sumitedu1305-embedd/ultrasonic_anemometer/PCB/new_pcb_v2/new_pcb_v2.step

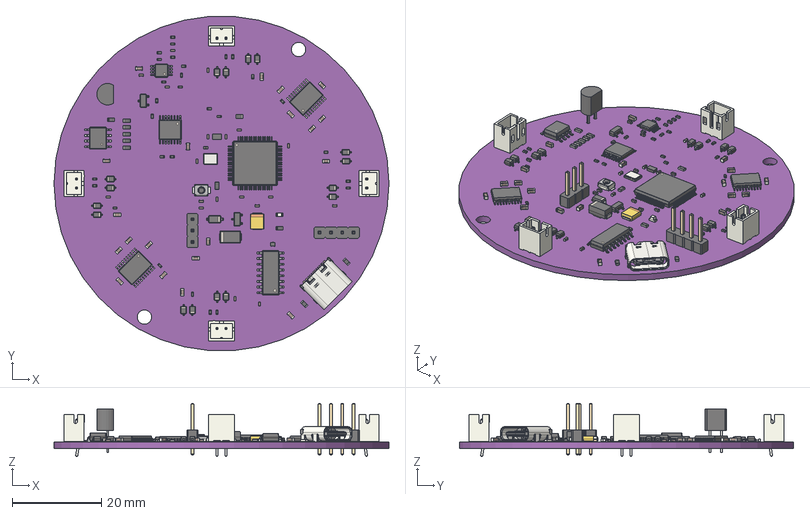
[picture p1: CAD file, 2026-08-26]
PCB/new_pcb_v2/new_pcb_v2.step
75.0 x 74.8 x 11.9 mm
SOT-23-3 x 2
PinHeader_1x03_P254mm_Vertical
C_0603_1608Metric x 20
R_0402_1005Metric x 29
D_SOD-323 x 16
MSOP-8_3x3mm_P0.65mm
C_0402_1005Metric x 20
SW_SPST_B3U-1000P
SO-8_3.9x4.9mm_P1.27mm
DRT_3
R_0603_1608Metric x 11
Crystal_SMD_Abracon_ABM8G-4Pin_3.2x2.5mm
JST_B2B_PH_K x 4
USB_C_Receptacle_16P_TopMnt_Horizontal_GCT_USB4105-xx-A
D_SOD-123
CP_EIA_3528_12_Kemet_T
TSSOP-16_4.4x5mm_P0.65mm
D_SMA
MicroCrystal_CC8V_T1A
PinHeader_1x04_P254mm_Vertical
SOIC-16_3.9x9.9mm_P1.27mm
LQFP-64_10x10mm_P0.5mm
TSSOP-20_4.4x6.5mm_P0.65mm x 2
LED_0603_1608Metric
TO-92-2_Narrow
new_pcb_v2_PCB
