sumitedu1305-embedd/ultrasonic_anemometer/PCB/new_pcb_v2/new_pcb_v2.pdf

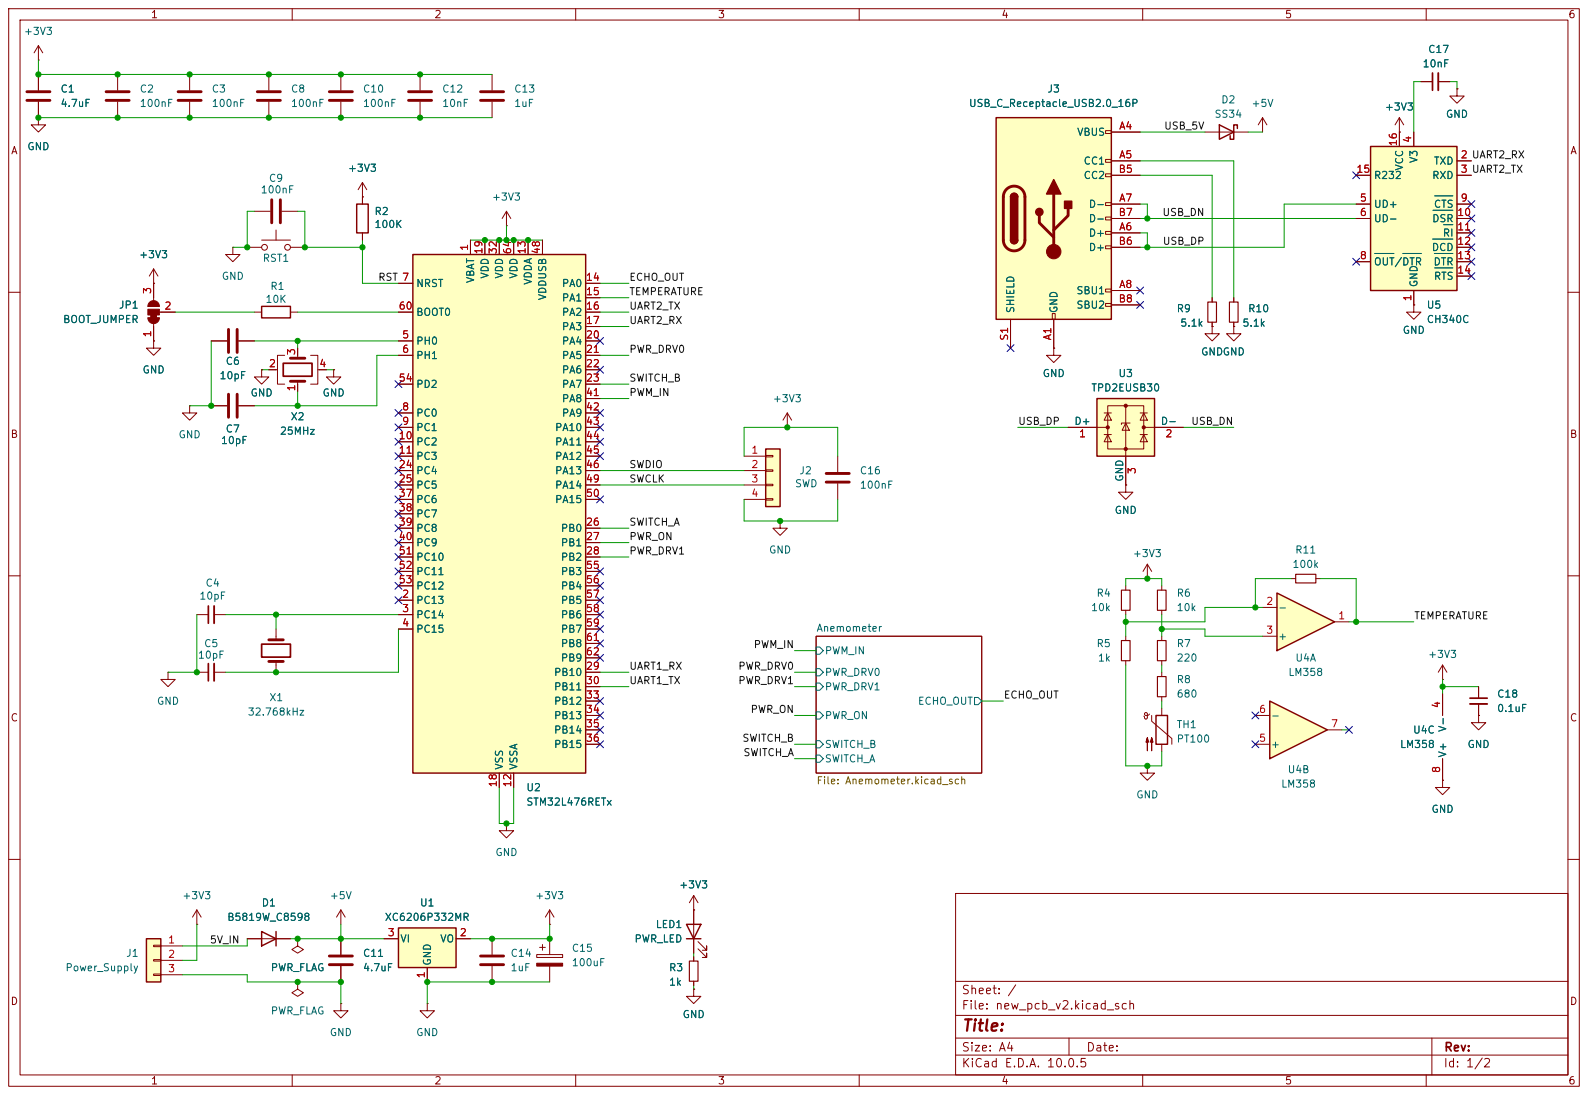
[picture p2: page 1]

4 UD+ 5 UD- 6 OUT/DTR 8 CTS 9 DSR 10 RI 11 DCD 12 DTR 13 RTS 14 R232 15 VCC 16 U5CH340C +5V D+

4 UD+ 5 UD- 6 OUT/DTR 8 CTS 9 DSR 10 RI 11 DCD 12 DTR 13 RTS 14 R232 15 VCC 16 GND

Size: A4 | Rev:
KiCad E.D.A. 10.0.5 | Id: 1/2

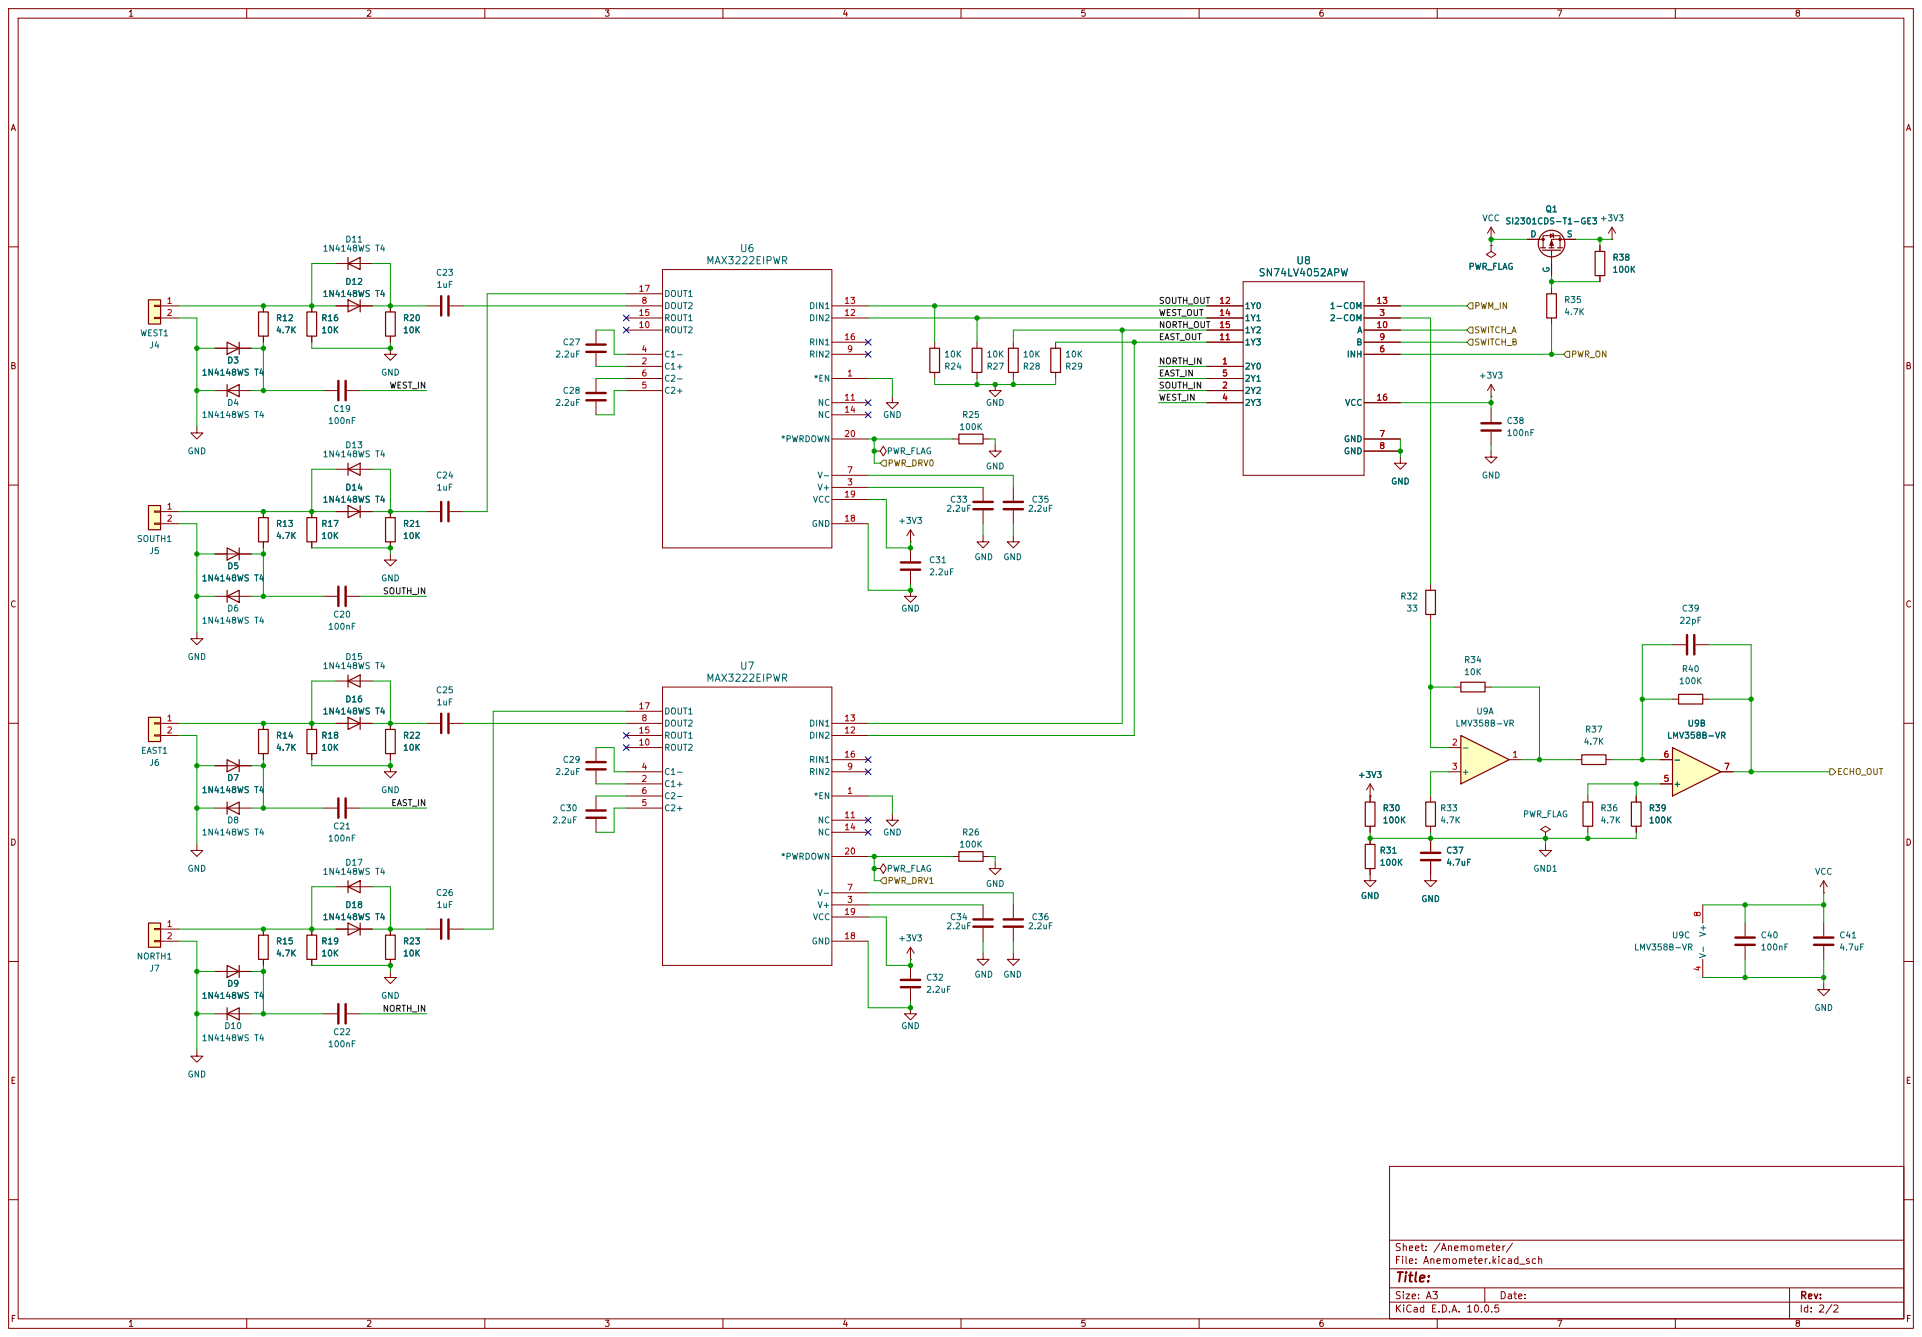
[picture p3: page 2]

Size: A3 | Rev: | F Date:
KiCad E.D.A. 10.0.5 | Id: 2/2
