sumitedu1305-embedd/ultrasonic_anemometer/PCB/new_pcb_v2/new_pcb_v2.kicad_pcb

## KiCad design PCB/new_pcb_v2/new_pcb_v2.kicad_pcb (2026-08-26)

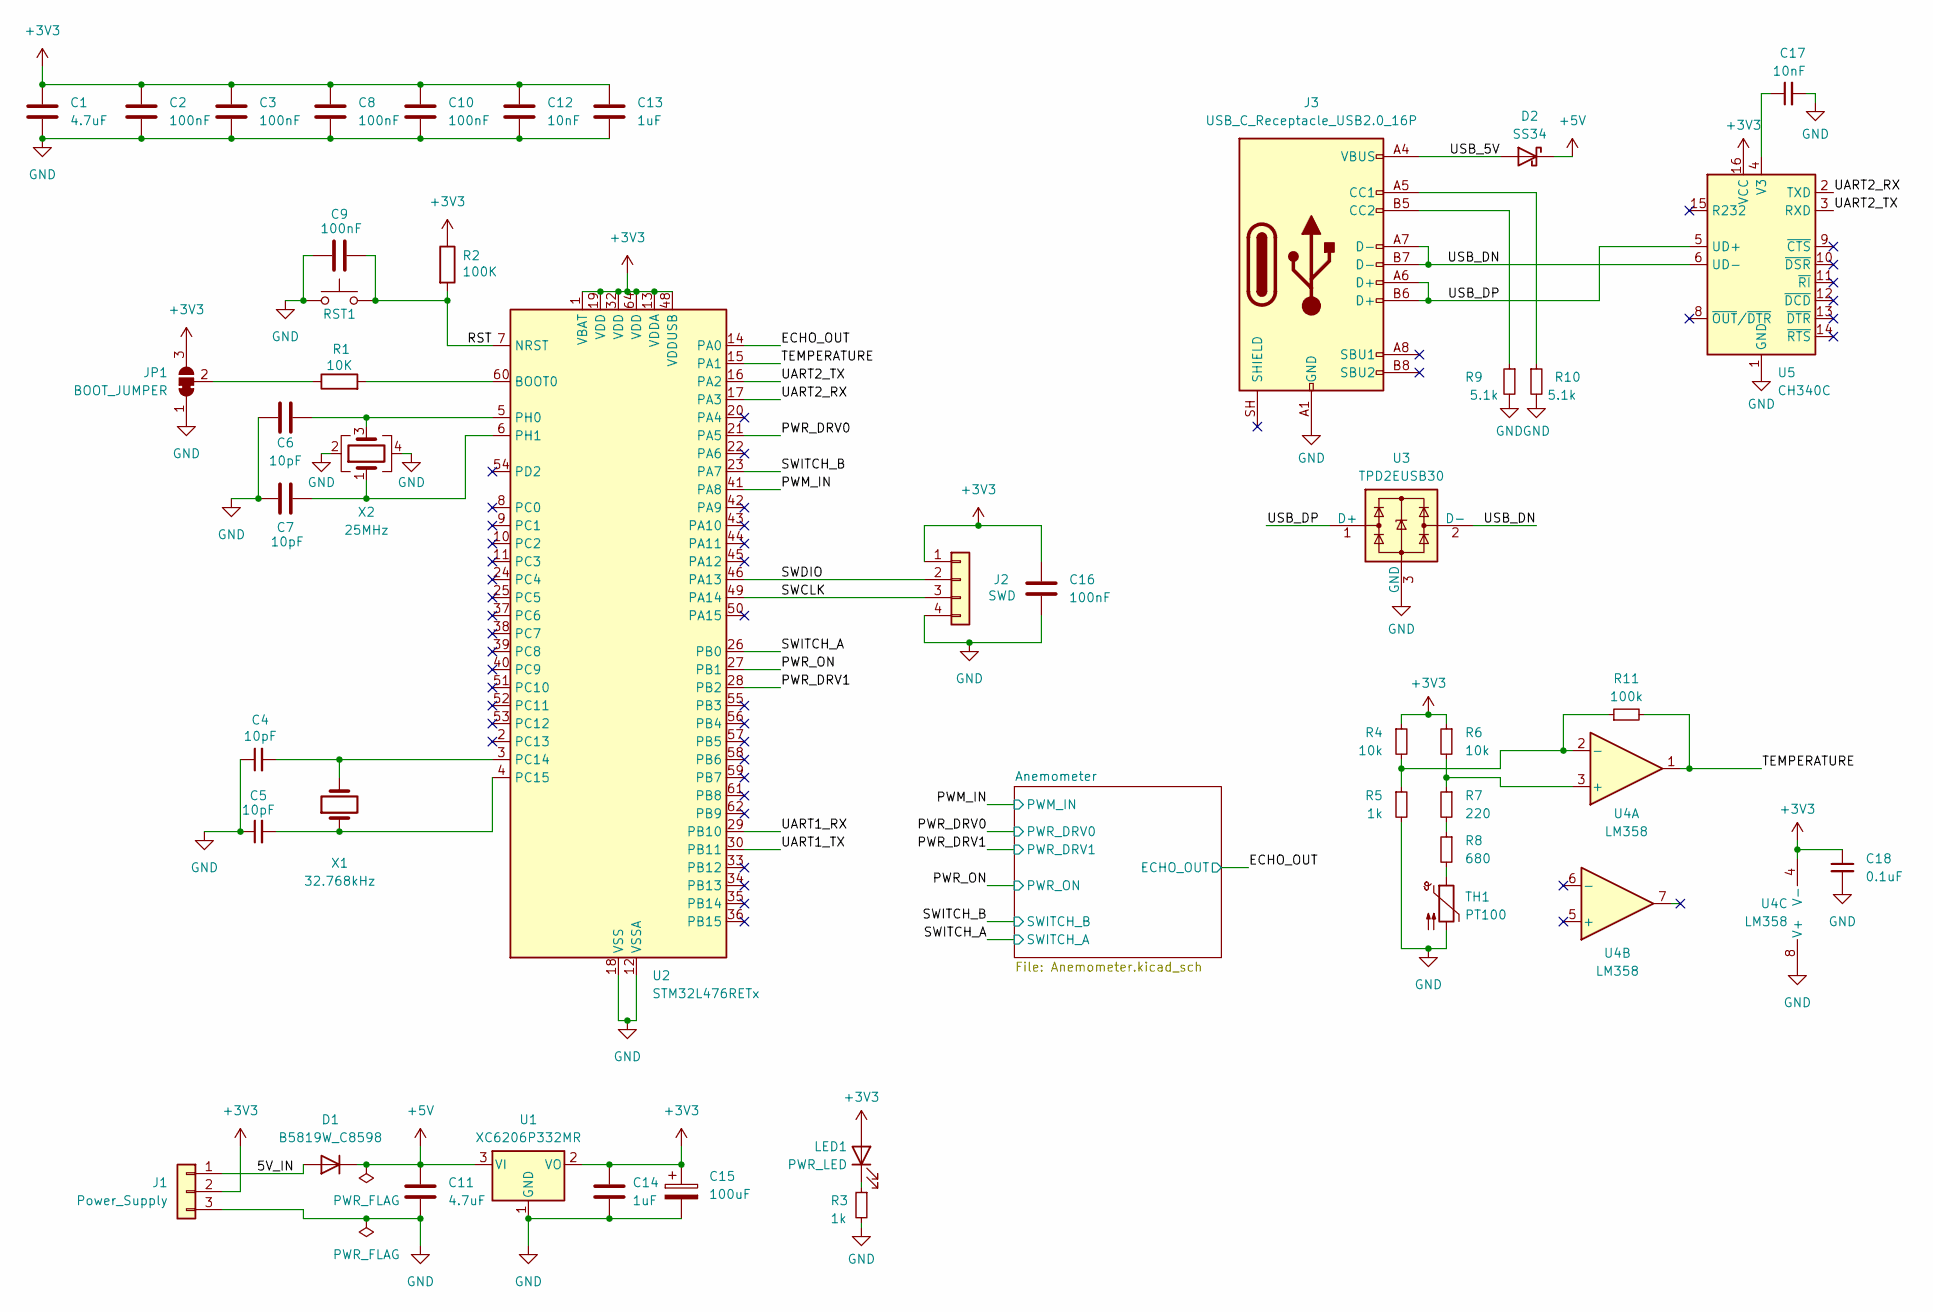
[picture p4: schematic new_pcb_v2.kicad_sch]

Parts:
C1, C11: 4.7uF; C_0603_1608Metric
C2, C3, C8, C9, C10, C16: 100nF; C_0402_1005Metric
C4, C5, C6, C7: 10pF; C_0402_1005Metric
C12: 10nF; C_0402_1005Metric
C13, C14: 1uF; C_0402_1005Metric
C15: 100uF; CP_EIA-3528-12_Kemet-T
C17: 10nF; C_0603_1608Metric
C18: 0.1uF; C_0603_1608Metric
D1: B5819W_C8598; D_SOD-123
D2: SS34; D_SMA
J1: Power_Supply; PinHeader_1x03_P2.54mm_Vertical
J2: SWD; PinHeader_1x04_P2.54mm_Vertical
J3: USB_C_Receptacle_USB2.0_16P; USB_C_Receptacle_G-Switch_GT-USB-7010ASV
JP1: BOOT_JUMPER; SolderJumper-3_P1.3mm_Bridged12_RoundedPad1.0x1.5mm_NumberL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
LED1: PWR_LED; LED_0603_1608Metric
R1: 10K; R_0603_1608Metric
R2: 100K; R_0603_1608Metric
R3, R5: 1k; R_0603_1608Metric
R4, R6: 10k; R_0603_1608Metric
R7: 220; R_0603_1608Metric
R8: 680; R_0603_1608Metric
R9, R10: 5.1k; R_0603_1608Metric
R11: 100k; R_0603_1608Metric
RST1: SW_Push; SW_SPST_B3U-1000P
TH1: PT100; TO-92-2
U1: XC6206P332MR; SOT-23-3
U2: STM32L476RETx; LQFP-64_10x10mm_P0.5mm
U3: TPD2EUSB30; Texas_DRT-3
U4: LM358; SO-8_3.9x4.9mm_P1.27mm
U5: CH340C; SOIC-16_3.9x9.9mm_P1.27mm
X1: 32.768kHz; Crystal_SMD_2012-2Pin_2.0x1.2mm
X2: 25MHz; Oscillator_SMD_Abracon_ASE-4Pin_3.2x2.5mm

Connections:
+3V3: C1.1, C2.1, C3.1, C8.1, C10.1, C12.1, C13.1, C14.1, C15.1, C16.1, C18.1, J1.2, J2.1, JP1.3 (B), LED1.2 (A), R2.1, R4.1, R6.1, U1.2 (VO), U2.1 (VBAT), U2.13 (VDDA), U2.19 (VDD), U2.32 (VDD), U2.48 (VDDUSB), U2.64 (VDD), U4.4 (V-), U5.16 (VCC); also elsewhere on the board
+5V: C11.1, D1.1 (K), D2.1 (K), U1.3 (VI)
/5V_IN: D1.2 (A), J1.1; also elsewhere on the board
/ECHO_OUT: U2.14 (PA0); also elsewhere on the board
/PWM_IN: U2.41 (PA8); also elsewhere on the board
/PWR_DRV0: U2.21 (PA5); also elsewhere on the board
/PWR_DRV1: U2.28 (PB2); also elsewhere on the board
/PWR_ON: U2.27 (PB1); also elsewhere on the board
/RST: C9.2, R2.2, RST1.2, U2.7 (NRST)
/SWCLK: J2.3, U2.49 (PA14); also elsewhere on the board
/SWDIO: J2.2, U2.46 (PA13); also elsewhere on the board
/SWITCH_A: U2.26 (PB0); also elsewhere on the board
/SWITCH_B: U2.23 (PA7); also elsewhere on the board
/TEMPERATURE: R11.2, U2.15 (PA1), U4.1
/UART1_RX: U2.29 (PB10)
/UART1_TX: U2.30 (PB11)
/UART2_RX: U2.17 (PA3), U5.2 (TXD)
/UART2_TX: U2.16 (PA2), U5.3 (RXD)
/USB_5V: D2.2 (A), J3.A4 (VBUS), J3.A9 (VBUS), J3.B4 (VBUS), J3.B9 (VBUS)
/USB_DN: J3.A7 (D-), J3.B7 (D-), U3.2 (D-), U5.6 (UD-)
/USB_DP: J3.A6 (D+), J3.B6 (D+), U3.1 (D+), U5.5 (UD+)
GND: C1.2, C2.2, C3.2, C4.1, C5.1, C6.1, C7.1, C8.2, C9.1, C10.2, C11.2, C12.2, C13.2, C14.2, C15.2, C16.2, C17.2, C18.2, J1.3, J2.4, J3.A1 (GND), J3.A12 (GND), J3.B1 (GND), J3.B12 (GND), JP1.1 (A), R3.2, R5.2, R9.2, R10.2, RST1.1, TH1.2, U1.1 (GND), U2.12 (VSSA), U2.18 (VSS), U2.31 (VSS), U2.47 (VSS), U2.63 (VSS), U3.3 (GND), U4.8 (V+), U5.1 (GND), X2.2, X2.4; also elsewhere on the board
unnamed: J3.A5 (CC1), R10.1
unnamed: J3.B5 (CC2), R9.1
unnamed: JP1.2 (C), R1.1
unnamed: LED1.1 (K), R3.1
unnamed: R7.2, R8.1
unnamed 49: R8.2, TH1.1; also elsewhere on the board
unnamed: R1.2, U2.60 (BOOT0)
unnamed: C4.2, U2.3 (PC14), X1.2
unnamed: C5.2, U2.4 (PC15), X1.1
unnamed: C6.2, U2.5 (PH0), X2.3
unnamed: C7.2, U2.6 (PH1), X2.1
unnamed: R6.2, R7.1, U4.3 (+)
unnamed: R4.2, R5.1, R11.1, U4.2 (-)
unnamed: C17.1, U5.4 (V3)

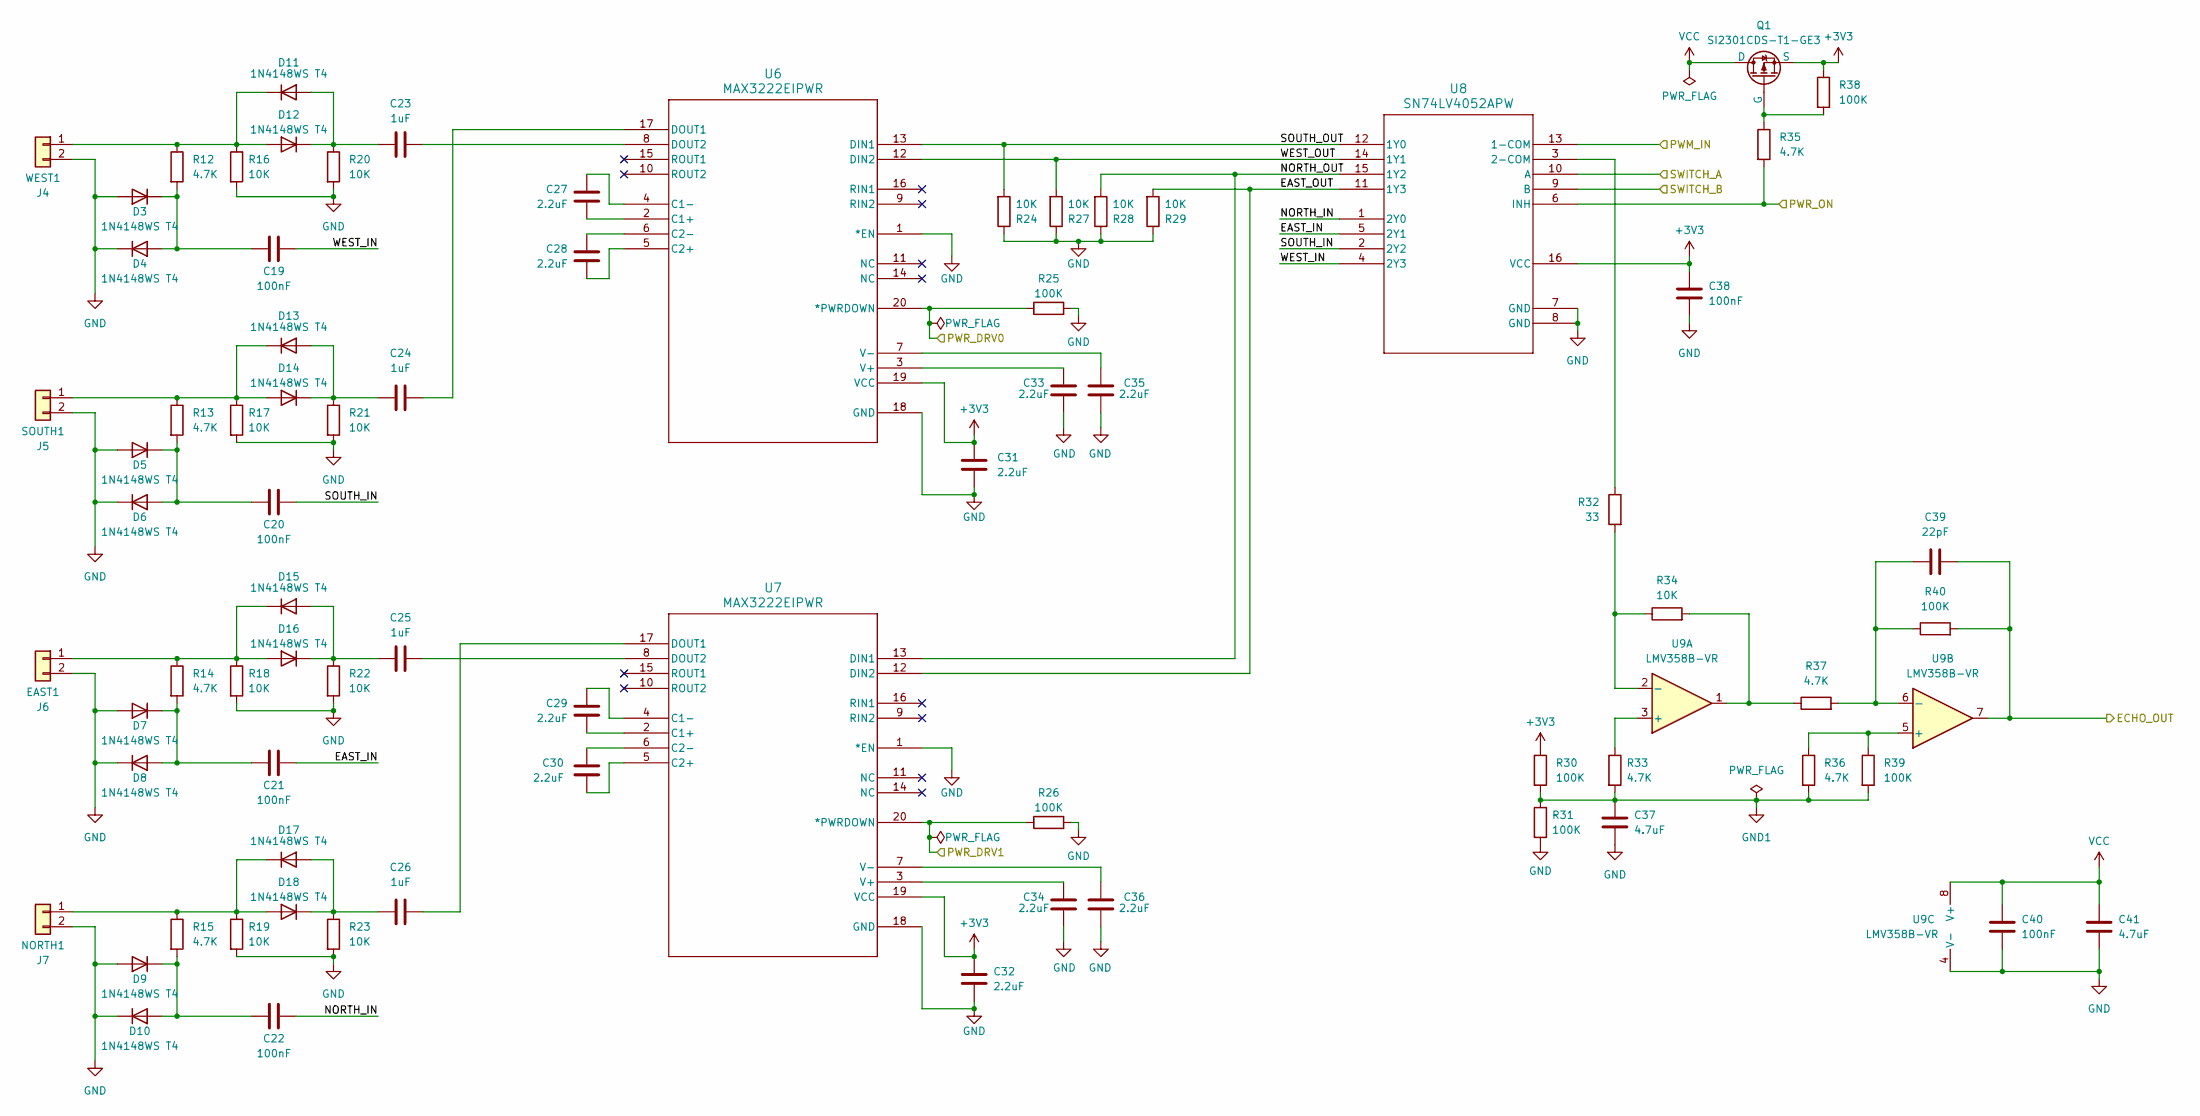
[picture p5: schematic Anemometer.kicad_sch]

Parts:
C19, C20, C21, C22, C40: 100nF; C_0402_1005Metric
C23, C24, C25, C26: 1uF; C_0603_1608Metric
C27, C28, C29, C30, C31, C32, C33, C34, C35, C36: 2.2uF; C_0603_1608Metric
C37: 4.7uF; C_0402_1005Metric
C38: 100nF; C_0603_1608Metric
C39: 22pF; C_0402_1005Metric
C41: 4.7uF; C_0603_1608Metric
D3, D4, D5, D6, D7, D8, D9, D10, D11, D12, D13, D14, D15, D16, D17, D18: 1N4148WS T4; D_SOD-323
J4: WEST1; JST_PH_B2B-PH-K_1x02_P2.00mm_Vertical
J5: SOUTH1; JST_PH_B2B-PH-K_1x02_P2.00mm_Vertical
J6: EAST1; JST_PH_B2B-PH-K_1x02_P2.00mm_Vertical
J7: NORTH1; JST_PH_B2B-PH-K_1x02_P2.00mm_Vertical
Q1: SI2301CDS-T1-GE3; SOT-23-3
R12, R13, R14, R15, R33, R35, R36, R37: 4.7K; R_0402_1005Metric
R16, R17, R18, R19, R20, R21, R22, R23, R24, R27, R28, R29, R34: 10K; R_0402_1005Metric
R25, R26, R30, R31, R38, R39, R40: 100K; R_0402_1005Metric
R32: 33; R_0402_1005Metric
U6, U7: MAX3222EIPWR; TSSOP-20_4.4x6.5mm_P0.65mm
U8: SN74LV4052APW; TSSOP-16_4.4x5mm_P0.65mm
U9: LMV358B-VR; MSOP-8_3x3mm_P0.65mm

Connections:
+3V3: C31.1, C32.1, C38.1, Q1.2 (S), R30.1, R38.1, U6.19 (VCC), U7.19 (VCC), U8.16 (VCC); also elsewhere on the board
/Anemometer/EAST_IN: C21.2, U8.5 (2Y1)
/Anemometer/EAST_OUT: R29.2, U7.12 (DIN2), U8.11 (1Y3)
/Anemometer/NORTH_IN: C22.2, U8.1 (2Y0)
/Anemometer/NORTH_OUT: R28.2, U7.13 (DIN1), U8.15 (1Y2)
/Anemometer/SOUTH_IN: C20.2, U8.2 (2Y2)
/Anemometer/SOUTH_OUT: R24.2, U6.13 (DIN1), U8.12 (1Y0)
/Anemometer/WEST_IN: C19.2, U8.4 (2Y3)
/Anemometer/WEST_OUT: R27.2, U6.12 (DIN2), U8.14 (1Y1)
/ECHO_OUT: C39.2, R40.2, U9.7; also elsewhere on the board
/PWM_IN: U8.13 (1-COM); also elsewhere on the board
/PWR_DRV0: R25.1, U6.20 (*PWRDOWN); also elsewhere on the board
/PWR_DRV1: R26.1, U7.20 (*PWRDOWN); also elsewhere on the board
/PWR_ON: R35.2, U8.6 (INH); also elsewhere on the board
/SWITCH_A: U8.10 (A); also elsewhere on the board
/SWITCH_B: U8.9 (B); also elsewhere on the board
GND: C31.2, C32.2, C33.1, C34.1, C35.1, C36.1, C37.2, C38.2, C40.2, C41.2, D3.2 (A), D4.1 (K), D5.2 (A), D6.1 (K), D7.2 (A), D8.1 (K), D9.2 (A), D10.1 (K), J4.2, J5.2, J6.2, J7.2, R16.2, R17.2, R18.2, R19.2, R20.2, R21.2, R22.2, R23.2, R24.1, R25.2, R26.2, R27.1, R28.1, R29.1, R31.2, U6.1 (*EN), U6.18 (GND), U7.1 (*EN), U7.18 (GND), U8.7 (GND), U8.8 (GND), U9.4 (V-); also elsewhere on the board
GND1: C37.1, R30.2, R31.1, R33.2, R36.2, R39.2
unnamed: C19.1, D3.1 (K), D4.2 (A), R12.2
unnamed: C20.1, D5.1 (K), D6.2 (A), R13.2
unnamed: C21.1, D7.1 (K), D8.2 (A), R14.2
unnamed: C22.1, D9.1 (K), D10.2 (A), R15.2
unnamed: C23.1, D11.2 (A), D12.1 (K), R20.1
unnamed 36: D11.1 (K), D12.2 (A), J4.1, R12.1, R16.1; also elsewhere on the board
unnamed: C24.1, D13.2 (A), D14.1 (K), R21.1
unnamed 38: D13.1 (K), D14.2 (A), J5.1, R13.1, R17.1; also elsewhere on the board
unnamed: C25.1, D15.2 (A), D16.1 (K), R22.1
unnamed 40: D15.1 (K), D16.2 (A), J6.1, R14.1, R18.1; also elsewhere on the board
unnamed: C26.1, D17.2 (A), D18.1 (K), R23.1
unnamed 42: D17.1 (K), D18.2 (A), J7.1, R15.1, R19.1; also elsewhere on the board
unnamed: Q1.1 (G), R35.1, R38.2
unnamed: R34.2, R37.1, U9.1
unnamed: C27.2, U6.2 (C1+)
unnamed: C27.1, U6.4 (C1-)
unnamed: C28.1, U6.5 (C2+)
unnamed: C28.2, U6.6 (C2-)
unnamed: C24.2, U6.17 (DOUT1)
unnamed: C23.2, U6.8 (DOUT2)
unnamed: C33.2, U6.3 (V+)
unnamed: C35.2, U6.7 (V-)
unnamed: C29.2, U7.2 (C1+)
unnamed: C29.1, U7.4 (C1-)
unnamed: C30.1, U7.5 (C2+)
unnamed: C30.2, U7.6 (C2-)
unnamed: C26.2, U7.17 (DOUT1)
unnamed: C25.2, U7.8 (DOUT2)
unnamed: C34.2, U7.3 (V+)
unnamed: C36.2, U7.7 (V-)
unnamed: R32.1, U8.3 (2-COM)
unnamed: R33.1, U9.3 (+)
unnamed: R32.2, R34.1, U9.2 (-)
unnamed: R36.1, R39.1, U9.5 (+)
unnamed: C39.1, R37.2, R40.1, U9.6 (-)
VCC: C40.1, C41.1, Q1.3 (D), U9.8 (V+)

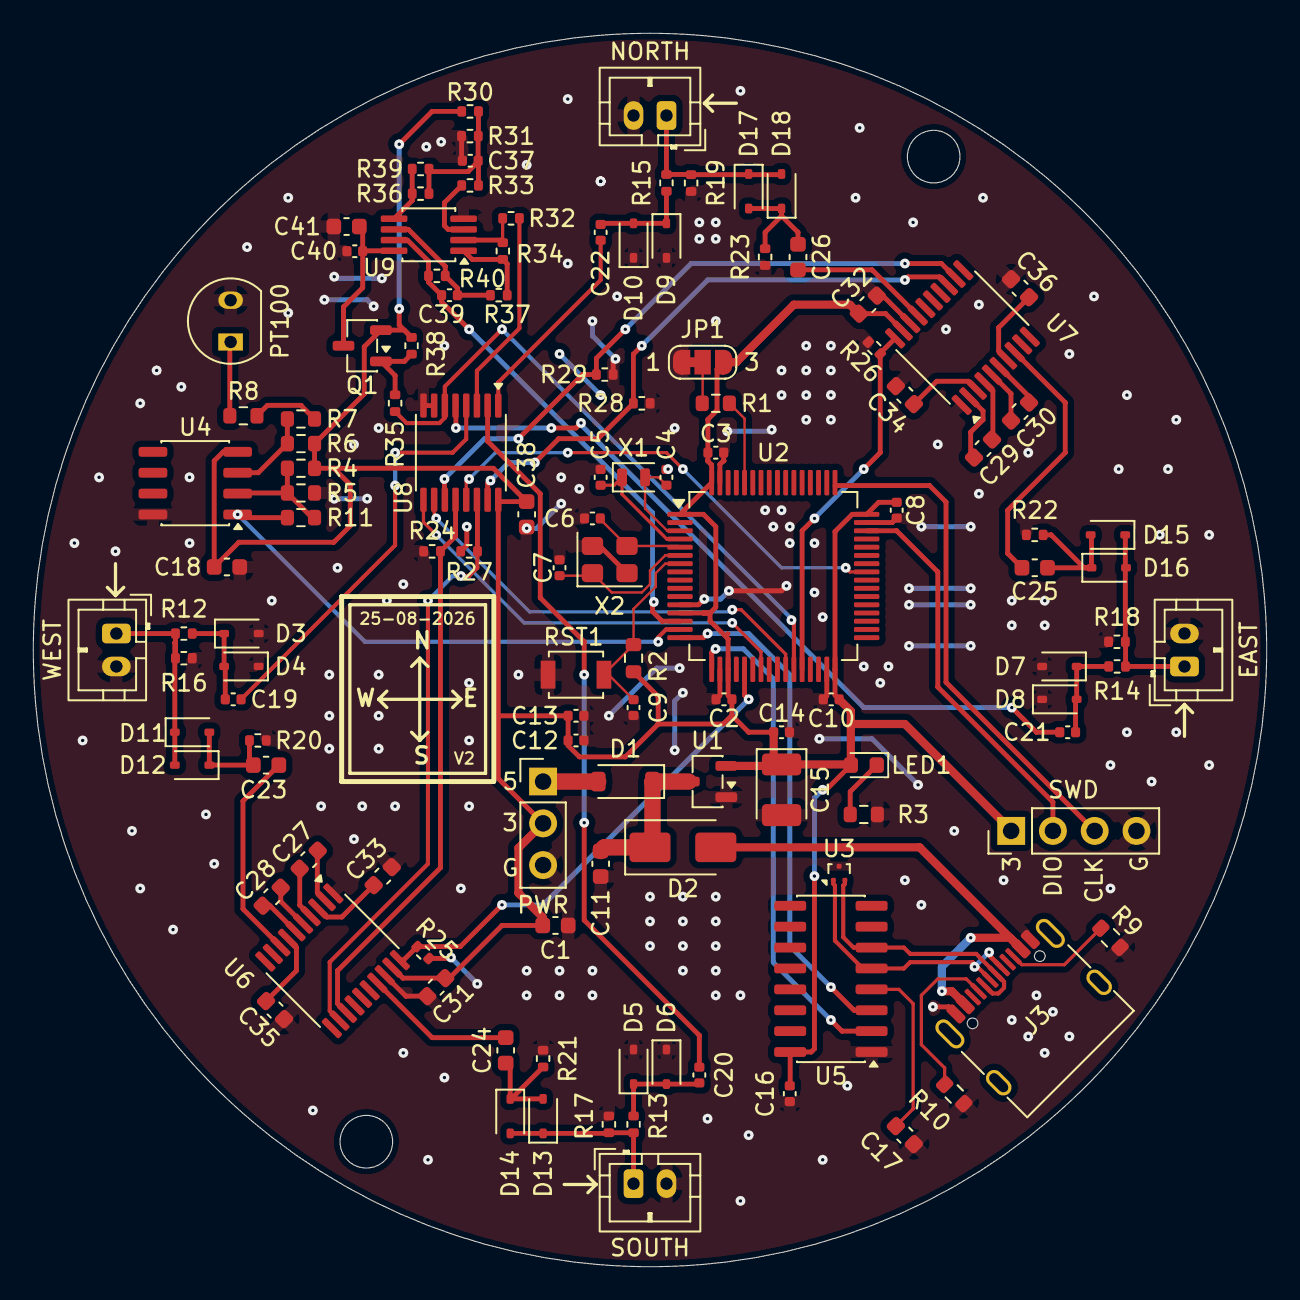
[picture p6: board new_pcb_v2.kicad_pcb from above]

Board: 2 copper layers, 75.0 x 75.0 mm, 122 parts (0 on the bottom side), 79 nets.

Other parts of the board:
EAST: EAST1; JST_PH_B2B-PH-K_1x02_P2.00mm_Vertical
NORTH: NORTH1; JST_PH_B2B-PH-K_1x02_P2.00mm_Vertical
PT100: PT100; TO-92-2
PWR: Power_Supply; PinHeader_1x03_P2.54mm_Vertical
SOUTH: SOUTH1; JST_PH_B2B-PH-K_1x02_P2.00mm_Vertical
SWD: SWD; PinHeader_1x04_P2.54mm_Vertical
WEST: WEST1; JST_PH_B2B-PH-K_1x02_P2.00mm_Vertical

Their connections:
+3V3: PWR.2, SWD.1; also elsewhere on the board
/5V_IN: PWR.1; also elsewhere on the board
/SWCLK: SWD.3; also elsewhere on the board
/SWDIO: SWD.2; also elsewhere on the board
GND: EAST.2, NORTH.2, PT100.2, PWR.3, SOUTH.2, SWD.4, WEST.2; also elsewhere on the board
unnamed 36: WEST.1; also elsewhere on the board
unnamed 38: SOUTH.1; also elsewhere on the board
unnamed 40: EAST.1; also elsewhere on the board
unnamed 42: NORTH.1; also elsewhere on the board
unnamed 49: PT100.1; also elsewhere on the board
