sumitedu1305-embedd/ultrasonic_anemometer/(commit log)

2026-04-09 Initial commit: firmware + python UART handling
2026-04-09 Added print statement for debugging in wind_0804.py
2026-04-10 smoothen + outliers filters added
2026-04-10 small updates 2 sensors though
2026-04-10 final 2 sensor update : smoothening
2026-04-10 2 sensors : mean changed to median due to more variations
2026-04-10 read frame changed sync + sequence mattered (sequence one was not attained at first
2026-04-10 4 Sensors : initial commit
2026-04-13 4 sensors 2nd commmit not working though
2026-04-13 changed firmware to reduce buffer size as there was problem in plotting (stops randomly) but didnt solved it. though keeping buffer smaller as more silent zone is not required. now improving data aqu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
    [main.c]
2026-04-13 python file resolved works fine now no changes to processing though
    [wind_1304.py]
2026-04-13 fixed wrong vectors for compass draw
    [wind_1304.py]
2026-04-13 fair results : calibration code still remaining
2026-04-13 calibration added : press c to calibrate
2026-04-13 fixes : calibration and buffer sizes
2026-04-20 no changes : switching v reflect branch
2026-05-26 working : fare working. assymetry may still needs to be solved. calibration without tunnel is difficult. also added signal processing in c but never integreted it so avoid it right now. signal proces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
    [main.c, main.h, wind_1304.py]
2026-05-28 changes : added temperature integration code to it. ye to be tested though
2026-06-04 working : temperature working and integrated. assymetry code also removed and manual calibrated ratios are added. fare operation though. yet to be tested along side reflector one
2026-07-09 calypso code added as reference. comparision.py give comparitison of data from calypso and reflectore one by reading .txt files. temperature is yet to be fulyl calibrated. starting work on new pcb fo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
2026-07-10 INITIAL COMMIT - new firmware required for new pcb changes thus .c .h will be modified
2026-08-26 Working : Chnaged many things ->
    - Added PCB folder for V2 version. V1 suffered from increased noise and thus betterment in V2.
    - Made the whole workflow of firmware in vscode. Thus keil specific file removed and Makefile with startup added
    - Added calibration function to the firmware to calibrate as per reference value and works fine right now
    - Added bootloader folder for future updates regarding OTA upgrade. Added linker scripts for both app and bootloader . However ignore right now as its not completed
    [Anemometer.kicad_sch, new_pcb_v2.kicad_pcb, new_pcb_v2.kicad_sch, new_pcb_v2.step, untitled.kicad_sch]
